KaiPereira/Alchemical-Cosmological-Badges/INNER_PCB/INNER_PCB.kicad_pcb

## KiCad design INNER_PCB/INNER_PCB.kicad_pcb (2026-11-10)

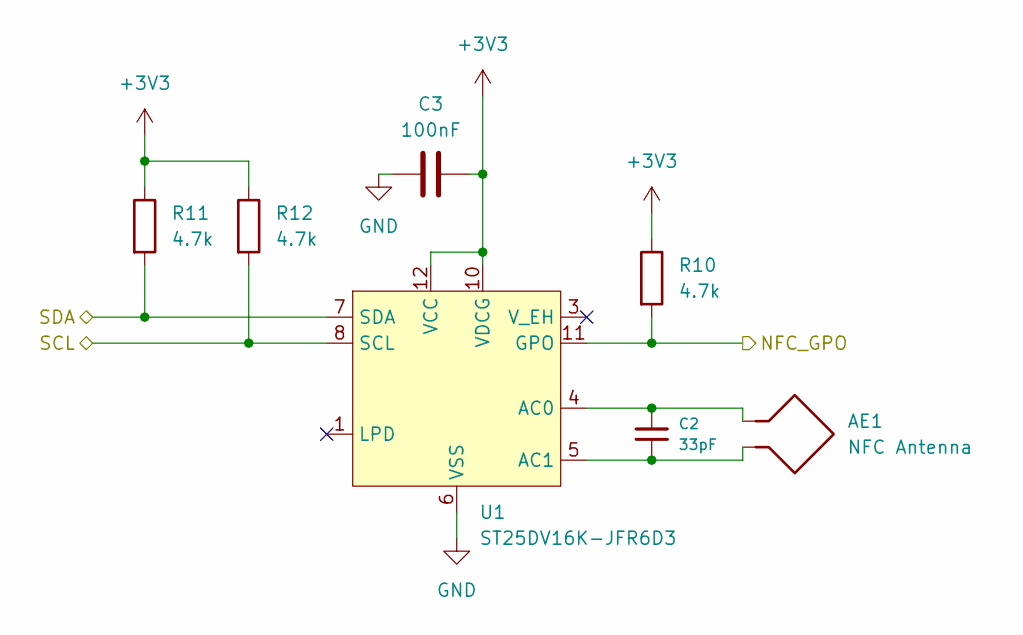
[picture p1: schematic NFC.kicad_sch]

Parts:
AE1: NFC Antenna; NFC_Coil_Round_D20mm_17T
C2: 33pF; C_0603_1608Metric; JLCPCB Part # C1663
C3: 100nF; C_0603_1608Metric; JLCPCB Part # C14663
R10, R11, R12: 4.7k; R_0603_1608Metric; JLCPCB Part # C23162
U1: ST25DV16K-JFR6D3; ST_UFDFPN-12-1EP_3x3mm_P0.5mm_EP1.4x2.55mm

Connections:
+3V3: C3.2, R10.1, R11.1, R12.1, U1.10 (VDCG), U1.12 (VCC); also elsewhere on the board
/MCU, Programming and Battery/NFC_GPO: R10.2, U1.11 (GPO); also elsewhere on the board
/MCU, Programming and Battery/SCL: R12.2, U1.8 (SCL); also elsewhere on the board
/MCU, Programming and Battery/SDA: R11.2, U1.7 (SDA); also elsewhere on the board
GND: C3.1, U1.6 (VSS); also elsewhere on the board
unnamed: AE1.1, C2.1, U1.4 (AC0)
unnamed: AE1.2, C2.2, U1.5 (AC1)

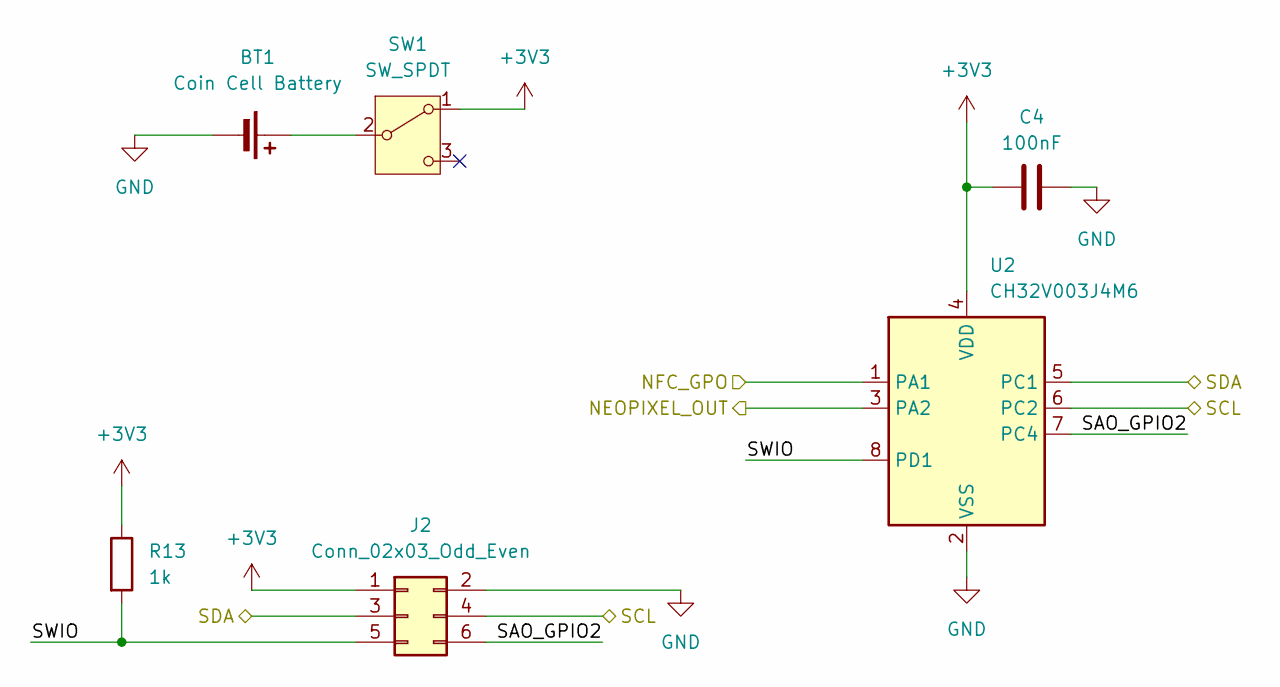
[picture p2: schematic MCU.kicad_sch]

Parts:
BT1: Coin Cell Battery; BatteryHolder_Keystone_1058_1x2032; JLCPCB Part # C70377
C4: 100nF; C_0603_1608Metric; JLCPCB Part # C14663
J2: Conn_02x03_Odd_Even; PinHeader_2x03_P2.54mm_Vertical_SMD
R13: 1k; R_0603_1608Metric; JLCPCB Part # C21190
SW1: SW_SPDT; SS-3292S-L1-B; JLCPCB Part # C397350
U2: CH32V003J4M6; SSOP-8_3.9x5.05mm_P1.27mm; LCSC Part # C5299908

Connections:
+3V3: C4.1, J2.1, R13.1, SW1.1 (A), U2.4 (VDD); also elsewhere on the board
/Connecting Solder Points/NEOPIXEL_IN: U2.3 (PA2); also elsewhere on the board
/MCU, Programming and Battery/NFC_GPO: U2.1 (PA1); also elsewhere on the board
/MCU, Programming and Battery/SAO_GPIO2: J2.6, U2.7 (PC4)
/MCU, Programming and Battery/SCL: J2.4, U2.6 (PC2); also elsewhere on the board
/MCU, Programming and Battery/SDA: J2.3, U2.5 (PC1); also elsewhere on the board
/MCU, Programming and Battery/SWIO: J2.5, R13.2, U2.8 (PD1)
GND: BT1.2 (-), C4.2, J2.2, U2.2 (VSS); also elsewhere on the board
unnamed: BT1.1 (+), SW1.2 (B)

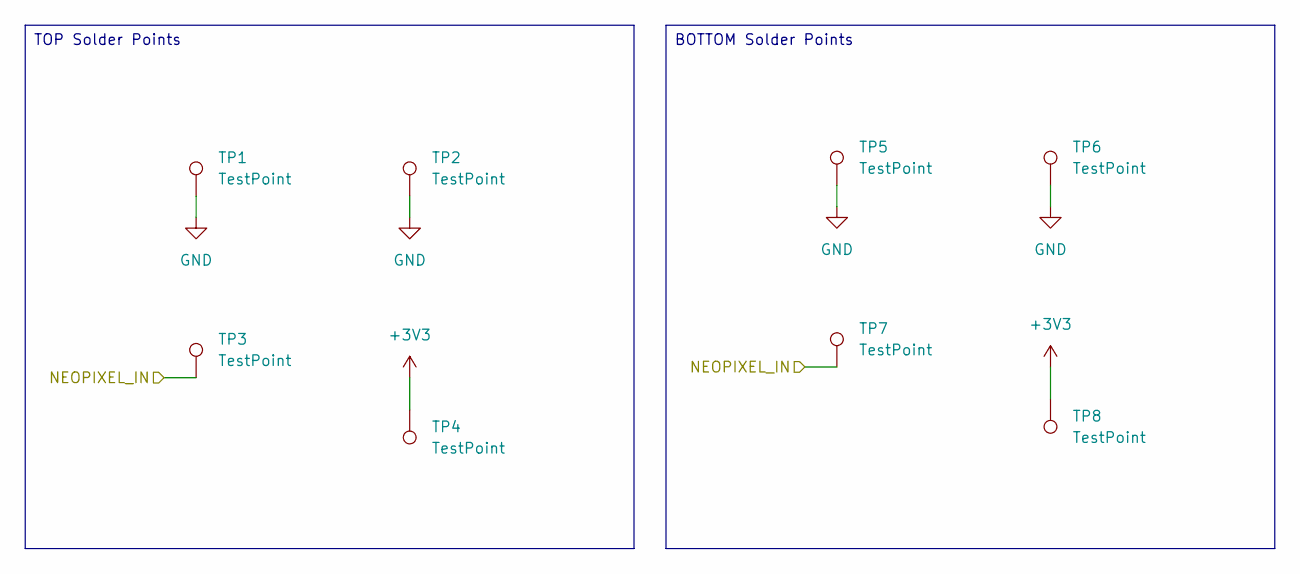
[picture p3: schematic solder-points.kicad_sch]

Parts:
TP1, TP2, TP3, TP4, TP5, TP6, TP7, TP8: TestPoint; TestPoint_Pad_3.0x3.0mm

Connections:
+3V3: TP4.1 (1_1), TP8.1 (1_1); also elsewhere on the board
/Connecting Solder Points/NEOPIXEL_IN: TP3.1 (1_1), TP7.1 (1_1); also elsewhere on the board
GND: TP1.1 (1_1), TP2.1 (1_1), TP5.1 (1_1), TP6.1 (1_1); also elsewhere on the board

Notes on the sheet:
TOP Solder Points
BOTTOM Solder Points

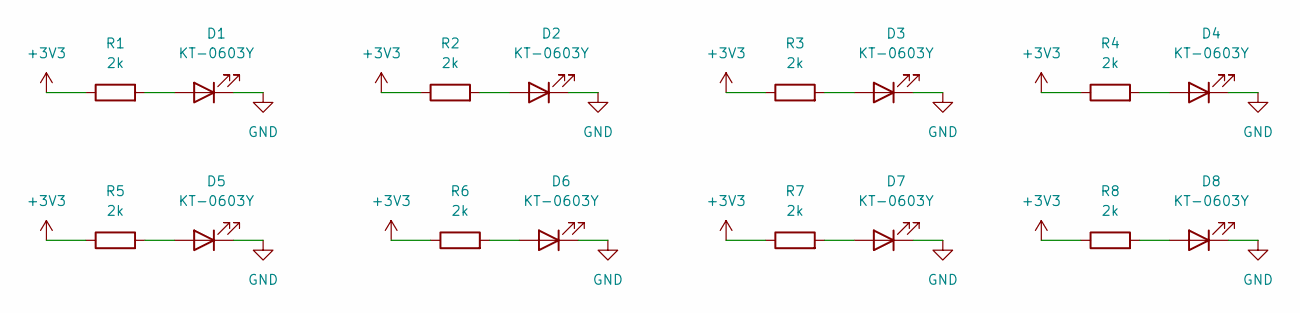
[picture p4: schematic LED.kicad_sch]

Parts:
D1, D2, D3, D4, D5, D6, D7, D8: KT-0603Y; LED_0603_1608Metric
R1, R2, R3, R4, R5, R6, R7, R8: 2k; R_0402_1005Metric

Connections:
+3V3: R1.1, R2.1, R3.1, R4.1, R5.1, R6.1, R7.1, R8.1; also elsewhere on the board
GND: D1.1 (K), D2.1 (K), D3.1 (K), D4.1 (K), D5.1 (K), D6.1 (K), D7.1 (K), D8.1 (K); also elsewhere on the board
unnamed: D1.2 (A), R1.2
unnamed: D2.2 (A), R2.2
unnamed: D3.2 (A), R3.2
unnamed: D4.2 (A), R4.2
unnamed: D5.2 (A), R5.2
unnamed: D6.2 (A), R6.2
unnamed: D7.2 (A), R7.2
unnamed: D8.2 (A), R8.2

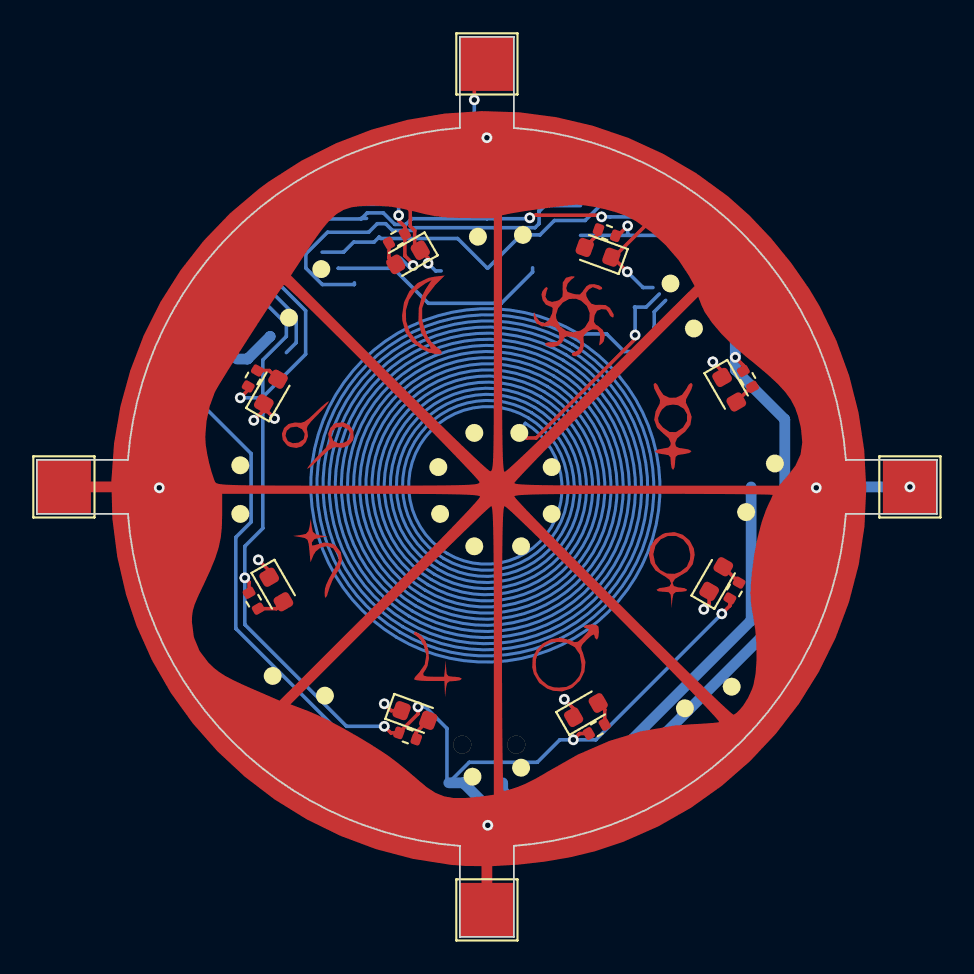
[picture p5: board INNER_PCB.kicad_pcb from above]

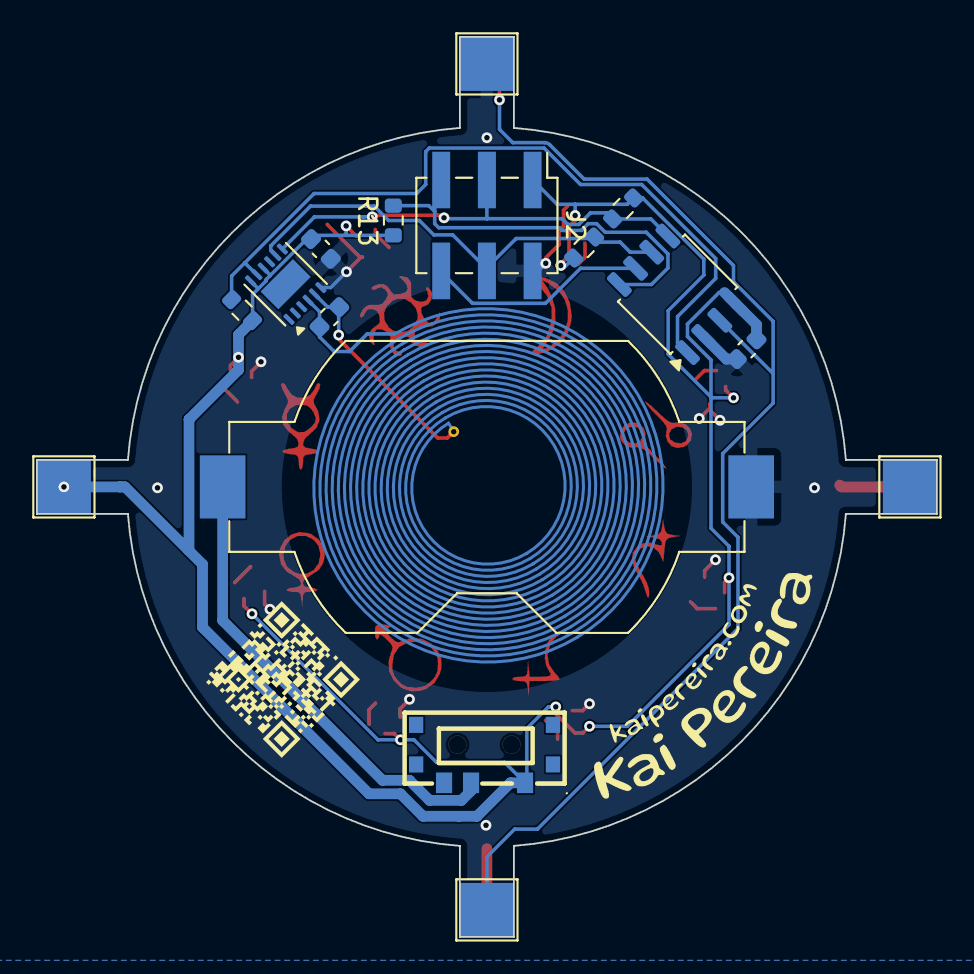
[picture p6: board INNER_PCB.kicad_pcb from below]

Board: 2 copper layers, 50.0 x 50.0 mm, 37 parts (17 on the bottom side), 19 nets.
