KaiPereira/Alchemical-Cosmological-Badges/(commit log)

2026-08-03 adding the ws2812b neopixel driver
2026-11-01 working on the inner part of the badge
    [INNER_PCB.kicad_pcb, INNER_PCB.kicad_sch, hackathon-badge.kicad_pcb, hackathon-badge.kicad_sch]
2026-11-04 adding battery
    [INNER_PCB.kicad_pcb, INNER_PCB.kicad_sch]
2026-11-05 massive res re-structuring changes to the electronics
    [INNER_PCB.kicad_pcb, INNER_PCB.kicad_sch, LED.kicad_sch, MCU.kicad_sch, NFC.kicad_sch, solder-points.kicad_sch]
2026-11-05 PCB layout with new components
    [INNER_PCB.kicad_pcb, INNER_PCB.kicad_sch, MCU.kicad_sch]
2026-11-10 adding silkscreen art
    [INNER_PCB.kicad_pcb]
2026-11-10 replacing pogo pins with SAO connector
    [INNER_PCB.kicad_pcb, MCU.kicad_sch]
